ernestojimenez2107/PCB-con-comunicacion-Infrarroja/README.md

<h1 align="center">📡 PCB de 4 capas · Arduino Nano + Infrarrojos</h1><p align="center">
  Del esquema eléctrico a una placa preparada para su revisión y fabricación.
  <br>
  <strong>Proyecto académico · EITE · Universidad de Las Palmas de Gran Canaria</strong>
</p><p align="center">
  
  
  
  
</p>✨ ¿De qué trata el proyecto?
Diseño de una placa de circuito impreso (PCB) de cuatro capas con Arduino Nano, conectores de expansión y un sistema de transmisión y recepción por infrarrojos. El circuito integra un oscilador de aproximadamente 40 kHz basado en un temporizador SE555D, lógica digital para controlar las señales y una etapa emisora y receptora de infrarrojos.

🔁 Diagrama de bloques

```mermaid
flowchart LR
    A["Arduino Nano"] -->|TX y control| L["Lógica digital"]
    O["Oscilador SE555D · 40 kHz"] --> L
    L --> E["LED IR · TSAL4400"]
    R["Receptor IR · TSOP18440"] --> X["Lógica de recepción"]
    X -->|RX| A
```
 Componentes principales
Bloque	Componentes / función

🧠 Control	Arduino Nano y conectores de expansión

⏱️ Oscilador	SE555D, señal de ~40 kHz

📤 Emisor IR	LED TSAL4400 y transistor MMBT2222A

📥 Receptor IR	TSOP18440

🔀 Lógica digital	74LVC2G86 y 74LVC2G08

⚡ Alimentación	Redes de 5 V, 3,3 V y masa

 Diseño de la PCB

Capa	Uso principal

🔴 TOP	Pistas y conexiones de la cara superior

🟢 GND	Plano interno de masa

🟠 POWER	Distribución de alimentación

🔵 BOTTOM	Pistas y conexiones de la cara inferior

La PCB incluye conectores, taladros de fijación, serigrafía y planos de cobre.
✅ Comprobaciones realizadas
- DRC de KiCad: 0 errores y 0 avisos en la última comprobación indicada.
- Archivos de fabricación: Gerber de las cuatro capas, máscaras, serigrafías y contorno.
- Taladrado: archivos PTH y NPTH generados.
- Montaje: archivo CSV de posición de componentes generado.
- Documentación: esquemas y capas de la PCB exportados a PDF.
[!IMPORTANT]
Antes de fabricar la PCB, hay que revisar los Gerber en el visor del fabricante y confirmar la compatibilidad de las huellas, la colocación de los conectores y los modelos 3D.

📂 Organización del repositorio

Practica_Diseno_PCB/
├── Práctica_Diseño_PCB.kicad_pro    # Proyecto KiCad

├── Práctica_Diseño_PCB.kicad_sch    # Esquema principal

├── Práctica_Diseño_PCB.kicad_pcb    # Diseño de la placa

├── arduino.kicad_sch               # Arduino y expansión

├── oscilador.kicad_sch             # Oscilador de 40 kHz

├── IR_Tx_Rx.kicad_sch              # Transmisor y receptor IR

├── alimentaciones.kicad_sch       # Alimentaciones

├── Fabricacion_PCB/                # Gerber y taladrado

├── Archivos de Montaje_PCB/        # Posiciones de componentes

├── Documentacion_PDF/              # PDF del esquema y la placa

La estructura muestra los archivos principales; los nombres de las carpetas de documentación pueden variar según la entrega.

El archivo de posición de componentes se encuentra en la carpeta de montaje. La BOM y el presupuesto de 10 y 100 placas forman parte de la documentación del proyecto, cuando se incluyan en el repositorio.
🎓 Contexto académico
Proyecto desarrollado para una práctica de diseño de circuitos impresos de la Escuela de Ingeniería de Telecomunicación y Electrónica (EITE) de la Universidad de Las Palmas de Gran Canaria (ULPGC).
<p align="center"><strong>🛠️ Diseñado con KiCad </strong></p>
