ernestojimenez2107/PCB-con-comunicacion-Infrarroja/BOM_Practica_Diseño_PCB.xlsx

Reference | Qty | Value | Footprint | Datasheet | Fabricante | Modelo | Proveedor | DigiKey | Descripción
A1 | 1 | Arduino_Nano_v3.x | MisPlacas:Arduino_Nano | https://mm.digikey.com/Volume0/opasdata/d220001/medias/docus/8938/1050_A000005.pdf | Arduino | A000005 | DigiKey | 1050-1001-ND | Arduino Nano v3.x
C1,C3,C4,C5 | 4 | 100n | Capacitor_SMD:C_0805_2012Metric_Pad1.18x1.45mm_HandSolder | https://mm.digikey.com/Volume0/opasdata/d220001/medias/docus/658/CL21B104KACNFNC_Spec.pdf | Samsung Electro-Mechanics | CL21B104KACNFNC | DigiKey | 1276-2442-1-ND | 0.1 µF ±10% 25V Ceramic Capacitor X7R 0805 (2012 Metric)
C2 | 1 | 15n | Capacitor_SMD:C_0805_2012Metric_Pad1.18x1.45mm_HandSolder | https://yageogroup.com/content/datasheet/asset/file/UPY-GPHC_X7R_6_3V-TO-250V | YAGEO | CC0805JRX7R9BB153 | DigiKey | 311-4273-1-ND | Unpolarized capacitor
D1 | 1 | SM5817PL-TP | MisDiodos:CR_5817PL-TP_MCC | https://www.mccsemi.com/pdf/Products/SM5817PL-SM5819PL(SOD-123FL).pdf | MCC (Micro Commercial Components) | SM5817PL-TP | DigiKey | SM5817PL-TPMSCT-ND | Diodo 20 V 1A Montaje superficial SOD-123FL
D2 | 1 | TSAL4400 | LED_THT:LED_D3.0mm_IRBlack | http://www.vishay.com/docs/81006/tsal4400.pdf | Vishay Semiconductor Opto Division | TSAL4400 | DigiKey | 751-1201-ND | Infrared (IR) Emitter 940nm 1.35V 100mA 16mW/sr @ 100mA 50° Radial, 3mm Dia (T-1)
J1 | 1 | Conn_01x02 | MisTerminales:282837-2_TYC | https://www.te.com/commerce/DocumentDelivery/DDEController?Action=srchrtrv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 | TE Connectivity AMP Connectors | 282837-2 | DigiKey | A113320-ND | Generic connector, single row, 01x02, script generated (kicad-library-utils/schlib/autogen/connector/)
J2,J3 | 2 | Conn_01x12 | Connector_PinHeader_2.54mm:PinHeader_1x12_P2.54mm_Vertical | https://app.adam-tech.com/products/download/data_sheet/201605/ph1-xx-ua-data-sheet.pdf | Adam Tech | PH1-12-UA | DigiKey | 2057-PH1-12-UA-ND | Generic connector, single row, 01x12, script generated (kicad-library-utils/schlib/autogen/connector/)
Q1 | 1 | MMBT2222A | Package_TO_SOT_SMD:SOT-23 | https://www.mccsemi.com/pdf/Products/MMBT2222A(SOT-23).pdf | MCC (Micro Commercial Components) | MMBT2222A-TP | DigiKey | MMBT2222ATPMSCT-ND | Bipolar (BJT) Transistor NPN 40 V 600 mA 300MHz 350 mW Surface Mount SOT-23
R1 | 1 | 200 | Resistor_SMD:R_0805_2012Metric_Pad1.20x1.40mm_HandSolder | https://www.seielect.com/catalog/SEI-RMCF_RMCP.pdf | Stackpole Electronics Inc | RMCF0805JT200R | DigiKey | RMCF0805JT200RCT-ND | Resistor
R2 | 1 | 1.1k | Resistor_SMD:R_0805_2012Metric_Pad1.20x1.40mm_HandSolder | https://www.seielect.com/catalog/SEI-RMCF_RMCP.pdf | Stackpole Electronics Inc | RMCF0805JT1K10 | DigiKey | RMCF0805JT1K10CT-ND | 1.1 kOhms ±5% 0.125W, 1/8W Chip Resistor 0805 (2012 Metric) Automotive AEC-Q200 Thick Film
R3 | 1 | 4k7 | Resistor_SMD:R_0805_2012Metric_Pad1.20x1.40mm_HandSolder | https://www.seielect.com/catalog/SEI-RMCF_RMCP.pdf | Stackpole Electronics Inc | RMCF0805JT4K70 | DigiKey | RMCF0805JT4K70CT-ND | 4.7 kOhms ±5% 0.125W, 1/8W Resistencia en microprocesador 0805 (2012 métrico) AEC-Q200 automotriz Película gruesa
R4 | 1 | 100 | Resistor_SMD:R_0805_2012Metric_Pad1.20x1.40mm_HandSolder | https://www.seielect.com/catalog/SEI-RMCF_RMCP.pdf | Stackpole Electronics Inc | RMCF0805JT100R | DigiKey | RMCF0805JT100RCT-ND | 100 Ohms ±5% 0.125W, 1/8W Chip Resistor 0805 (2012 Metric) Automotive AEC-Q200 Thick Film
U1 | 1 | SE555D | Package_SO:SOIC-8_3.9x4.9mm_P1.27mm | http://www.ti.com/lit/ds/symlink/ne555.pdf | Texas Instruments | NE555DR | DigiKey | 296-6501-1-ND | Precision Timers, 555 compatible, SOIC-8
U2 | 1 | TSOP18440 | OptoDevice:Vishay_MOLD-3Pin | https://www.vishay.com/docs/82739/tsop184.pdf | Vishay Semiconductor Opto Division | TSOP18440 | DigiKey | TSOP18440-ND | Remote Receiver Sensor 40.0kHz 24m Through Hole
U3 | 1 | 74LVC2G86 | Package_SO:VSSOP-8_3x3mm_P0.65mm | https://www.ti.com/lit/ds/symlink/sn74lvc2g08.pdf?HQS=dis-dk-null-digikeymode-dsf-pf-null-wwe&ts=1790792621465 | Texas Instruments | SN74LVC2G86DCUR | DigiKey | 296-13275-1-ND | XOR (OR exclusivo) IC 2 Canal 8-VSSOP
U4 | 1 | 74LVC2G08 | Package_SO:VSSOP-8_3x3mm_P0.65mm | http://www.ti.com/lit/sg/scyt129e/scyt129e.pdf | Texas Instruments | SN74LVC2G08DCTR | DigiKey | 296-13263-1-ND | Dual AND Gate, Low-Voltage CMOS
