ernestojimenez2107/PCB-con-comunicacion-Infrarroja/Presupuesto_10 y 100 placas.xlsx

Sheet: 10 placas
Referencia | Valor | Fabricante | Modelo | DigiKey | Cantidad por placa | Cantidad total | Precio unitario | Precio total (€) | Moneda | País de compra | Enlace DigiKey
A1 | Arduino_Nano_v3.x | Arduino | A000005 | 1050-1001-ND | 1 | 10 | 22.361 | 223.61 | EUR | España | https://www.digikey.es/es/products/detail/arduino/A000005/2638989
C1,C3,C4,C5 | 100n | Samsung Electro-Mechanics | CL21B104KACNFNC | 1276-2442-1-ND | 4 | 40 | 0.026 | 1.04 | EUR | España | https://www.digikey.es/es/products/detail/samsung-electro-mechanics/CL21B104KACNFNC/3888100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
C2 | 15n | YAGEO | CC0805JRX7R9BB153 | 311-4273-1-ND | 1 | 10 | 0.088 | 0.88 | EUR | España | https://www.digikey.es/es/products/detail/yageo/CC0805JRX7R9BB153/5884116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
D1 | SM5817PL-TP | MCC (Micro Commercial Components) | SM5817PL-TP | SM5817PL-TPMSCT-ND | 1 | 10 | 0.138 | 1.38 | USD | Estados Unidos | https://www.digikey.com/es/products/detail/mcc-micro-commercial-components/SM5817PL-TP/1793251
D2 | TSAL4400 | Vishay Semiconductor Opto Division | TSAL4400 | 751-1201-ND | 1 | 10 | 0.289 | 2.89 | EUR | España | https://www.digikey.es/es/products/detail/vishay-semiconductor-opto-division/TSAL4400/1681336
J1 | Conn_01x02 | TE Connectivity AMP Connectors | 282837-2 | A113320-ND | 1 | 10 | 0.656 | 6.56 | EUR | España | https://www.digikey.es/es/products/detail/te-connectivity-amp-connectors/282837-2/2187973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
J2,J3 | Conn_01x12 | Adam Tech | PH1-12-UA | 2057-PH1-12-UA-ND | 2 | 20 | 0.133 | 2.66 | EUR | España | https://www.digikey.es/es/products/detail/adam-tech/PH1-12-UA/9830395
Q1 | MMBT2222A | MCC (Micro Commercial Components) | MMBT2222A-TP | MMBT2222ATPMSCT-ND | 1 | 10 | 0.078 | 0.78 | USD | Estados Unidos | https://www.digikey.com/es/products/detail/micro-commercial-co/MMBT2222A-TP/MMBT2222ATPMSCT-ND/717394
R1 | 200 | Stackpole Electronics Inc | RMCF0805JT200R | RMCF0805JT200RCT-ND | 1 | 10 | 0.02 | 0.2 | EUR | España | https://www.digikey.es/es/products/detail/stackpole-electronics-inc/RMCF0805JT200R/1757898
R2 | 1.1k | Stackpole Electronics Inc | RMCF0805JT1K10 | RMCF0805JT1K10CT-ND | 1 | 10 | 0.02 | 0.2 | EUR | España | https://www.digikey.es/es/products/detail/stackpole-electronics-inc/RMCF0805JT1K10/1757802
R3 | 4k7 | Stackpole Electronics Inc | RMCF0805JT4K70 | RMCF0805JT4K70CT-ND | 1 | 10 | 0.02 | 0.2 | EUR | España | https://www.digikey.es/es/products/detail/stackpole-electronics-inc/RMCF0805JT4K70/1757774
R4 | 100 | Stackpole Electronics Inc | RMCF0805JT100R | RMCF0805JT100RCT-ND | 1 | 10 | 0.02 | 0.2 | EUR | España | https://www.digikey.es/es/products/detail/stackpole-electronics-inc/RMCF0805JT100R/1757756
U1 | SE555D | Texas Instruments | NE555DR | 296-6501-1-ND | 1 | 10 | 0.205 | 2.05 | EUR | España | https://www.digikey.es/es/products/detail/texas-instruments/NE555DR/372491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
U2 | TSOP18440 | Vishay Semiconductor Opto Division | TSOP18440 | TSOP18440-ND | 1 | 10 | 0.636 | 6.36 | EUR | España | https://www.digikey.es/es/products/detail/vishay-semiconductor-opto-division/TSOP18440/8556535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
U3 | 74LVC2G86 | Texas Instruments | SN74LVC2G86DCUR | 296-13275-1-ND | 1 | 10 | 0.309 | 3.09 | EUR | España | https://www.digikey.es/es/products/detail/texas-instruments/SN74LVC2G86DCUR/484697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
U4 | 74LVC2G08 | Texas Instruments | SN74LVC2G08DCTR | 296-13263-1-ND | 1 | 10 | 0.32 | 3.2 | EUR | España | https://www.digikey.es/es/products/detail/texas-instruments/SN74LVC2G08DCTR/484829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

Sheet: 100 placas
Referencia | Valor | Fabricante | Modelo | DigiKey | Cantidad por placa | Cantidad total | Precio unitario | Precio total | Moneda | País de compra | Enlace DigiKey
A1 | Arduino_Nano_v3.x | Arduino | A000005 | 1050-1001-ND | 1 | 100 | 20.4172 | 2041.72 | EUR | España | https://www.digikey.es/es/products/detail/arduino/A000005/2638989
C1,C3,C4,C5 | 100n | Samsung Electro-Mechanics | CL21B104KACNFNC | 1276-2442-1-ND | 4 | 400 | 0.0146 | 5.84 | EUR | España | https://www.digikey.es/es/products/detail/samsung-electro-mechanics/CL21B104KACNFNC/3888100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
C2 | 15n | YAGEO | CC0805JRX7R9BB153 | 311-4273-1-ND | 1 | 100 | 0.0534 | 5.34 | EUR | España | https://www.digikey.es/es/products/detail/yageo/CC0805JRX7R9BB153/5884116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
D1 | SM5817PL-TP | MCC (Micro Commercial Components) | SM5817PL-TP | SM5817PL-TPMSCT-ND | 1 | 100 | 0.0849 | 8.49 | USD | Estados Unidos | https://www.digikey.com/es/products/detail/mcc-micro-commercial-components/SM5817PL-TP/1793251
D2 | TSAL4400 | Vishay Semiconductor Opto Division | TSAL4400 | 751-1201-ND | 1 | 100 | 0.2072 | 20.72 | EUR | España | https://www.digikey.es/es/products/detail/vishay-semiconductor-opto-division/TSAL4400/1681336
J1 | Conn_01x02 | TE Connectivity AMP Connectors | 282837-2 | A113320-ND | 1 | 100 | 0.466 | 46.6 | EUR | España | https://www.digikey.es/es/products/detail/te-connectivity-amp-connectors/282837-2/2187973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
J2,J3 | Conn_01x12 | Adam Tech | PH1-12-UA | 2057-PH1-12-UA-ND | 2 | 200 | 0.1134 | 22.68 | EUR | España | https://www.digikey.es/es/products/detail/adam-tech/PH1-12-UA/9830395
Q1 | MMBT2222A | MCC (Micro Commercial Components) | MMBT2222A-TP | MMBT2222ATPMSCT-ND | 1 | 100 | 0.048 | 4.8 | USD | Estados Unidos | https://www.digikey.com/es/products/detail/micro-commercial-co/MMBT2222A-TP/MMBT2222ATPMSCT-ND/717394
R1 | 200 | Stackpole Electronics Inc | RMCF0805JT200R | RMCF0805JT200RCT-ND | 1 | 100 | 0.0095 | 0.95 | EUR | España | https://www.digikey.es/es/products/detail/stackpole-electronics-inc/RMCF0805JT200R/1757898
R2 | 1.1k | Stackpole Electronics Inc | RMCF0805JT1K10 | RMCF0805JT1K10CT-ND | 1 | 100 | 0.0095 | 0.95 | EUR | España | https://www.digikey.es/es/products/detail/stackpole-electronics-inc/RMCF0805JT1K10/1757802
R3 | 4k7 | Stackpole Electronics Inc | RMCF0805JT4K70 | RMCF0805JT4K70CT-ND | 1 | 100 | 0.0095 | 0.95 | EUR | España | https://www.digikey.es/es/products/detail/stackpole-electronics-inc/RMCF0805JT4K70/1757774
R4 | 100 | Stackpole Electronics Inc | RMCF0805JT100R | RMCF0805JT100RCT-ND | 1 | 100 | 0.0095 | 0.95 | EUR | España | https://www.digikey.es/es/products/detail/stackpole-electronics-inc/RMCF0805JT100R/1757756
U1 | SE555D | Texas Instruments | NE555DR | 296-6501-1-ND | 1 | 100 | 0.1569 | 15.69 | EUR | España | https://www.digikey.es/es/products/detail/texas-instruments/NE555DR/372491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
U2 | TSOP18440 | Vishay Semiconductor Opto Division | TSOP18440 | TSOP18440-ND | 1 | 100 | 0.5413 | 54.13 | EUR | España | https://www.digikey.es/es/products/detail/vishay-semiconductor-opto-division/TSOP18440/8556535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
U3 | 74LVC2G86 | Texas Instruments | SN74LVC2G86DCUR | 296-13275-1-ND | 1 | 100 | 0.2397 | 23.97 | EUR | España | https://www.digikey.es/es/products/detail/texas-instruments/SN74LVC2G86DCUR/484697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
U4 | 74LVC2G08 | Texas Instruments | SN74LVC2G08DCTR | 296-13263-1-ND | 1 | 100 | 0.2486 | 24.86 | EUR | España | https://www.digikey.es/es/products/detail/texas-instruments/SN74LVC2G08DCTR/484829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

Sheet: Resumen
DigiKey España |  |  | RESUMEN FINAL | 10 placas (IVA) | 10 placas (IGIC) | 100 placas (IVA) | 100 placas (IGIC)
Concepto | 10 placas | 100 placas | Total DigiKey España | 306.2994 | 270.8598 | 2741.0735 | 2423.9245
Componentes España (€) | 253.14 | 2265.35 | Total DigiKey EEUU | 40.17169024 | 35.52372608 | 52.20337606 | 46.16331602
Transporte (€) | GRATIS | GRATIS | Total Presupuesto | 346.4710902 | 306.3835261 | 2793.276876 | 2470.087816
Total componentes (€) | 253.14 | 2265.35
Aduanas y gestión (€) | 0 * | 0 *
IVA aplicable (€) | 53.1594 | 475.7235
IGIC (€) | 17.7198 | 158.5745
TOTAL FINAL (con IVA) | 306.2994 | 2741.0735
TOTAL FINAL (con IGIC) | 270.8598 | 2423.9245
*Se supone que los gastos aduaneros los asume DigiKey mediante DDP. Los importes son provisionales y no incluyen cargos adicionales que pudieran aplicarse.
DigiKey EEUU
Concepto | 10 placas | 100 placas
Componentes EEUU (USD) | 2.16 | 13.29
Conversión USD a EUR | 1.929744 | 11.873286
Transporte (€) | 31.27 | 31.27
Aduanas y gestión (€) | 0 * | 0 *
IVA aplicable (€) | 6.97194624 | 9.06009006
IGIC (€) | 2.32398208 | 3.02003002
TOTAL FINAL con IVA(€) | 40.17169024 | 52.20337606
TOTAL FINAL con IGIC(€) | 35.52372608 | 46.16331602
*Se supone que los gastos aduaneros los asume DigiKey mediante DDP. Los importes son provisionales y no incluyen cargos adicionales que pudieran aplicarse.
