ernestojimenez2107/PCB-con-comunicacion-Infrarroja/Placa_pdf.pdf

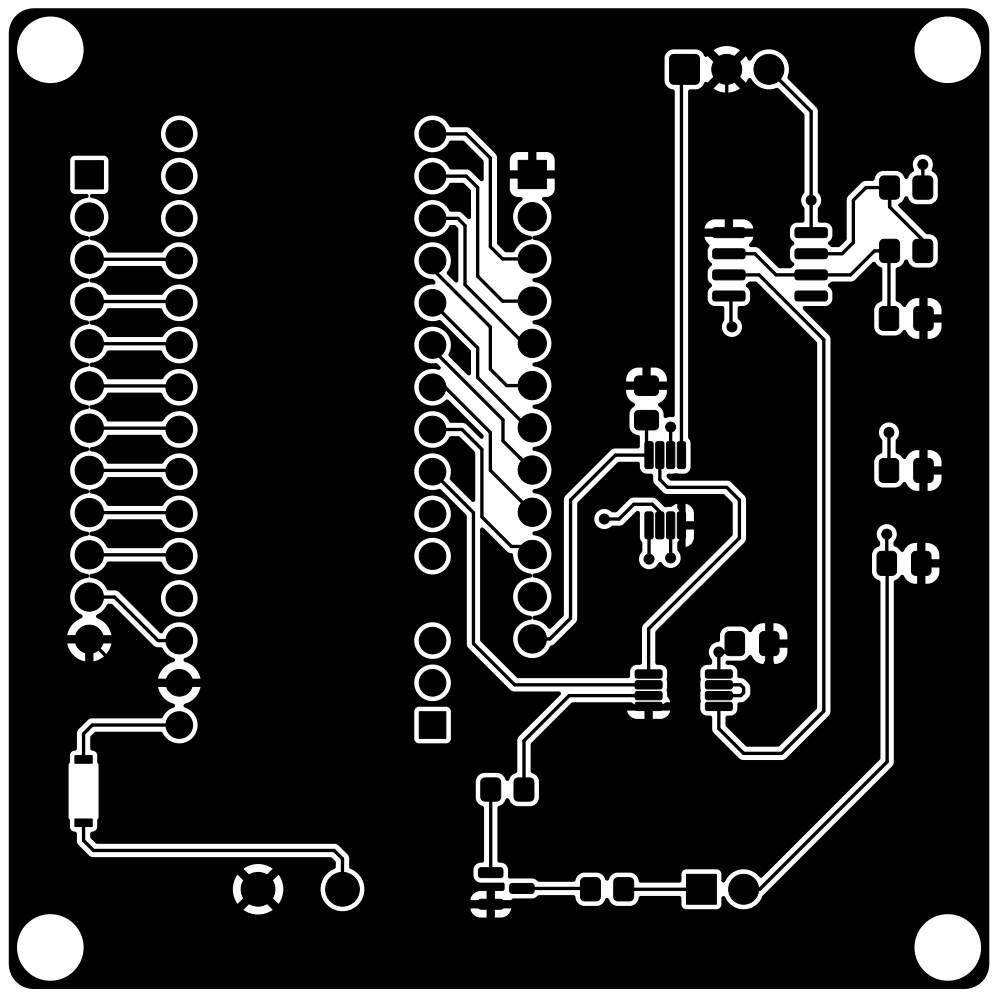
[picture p1: page 1]

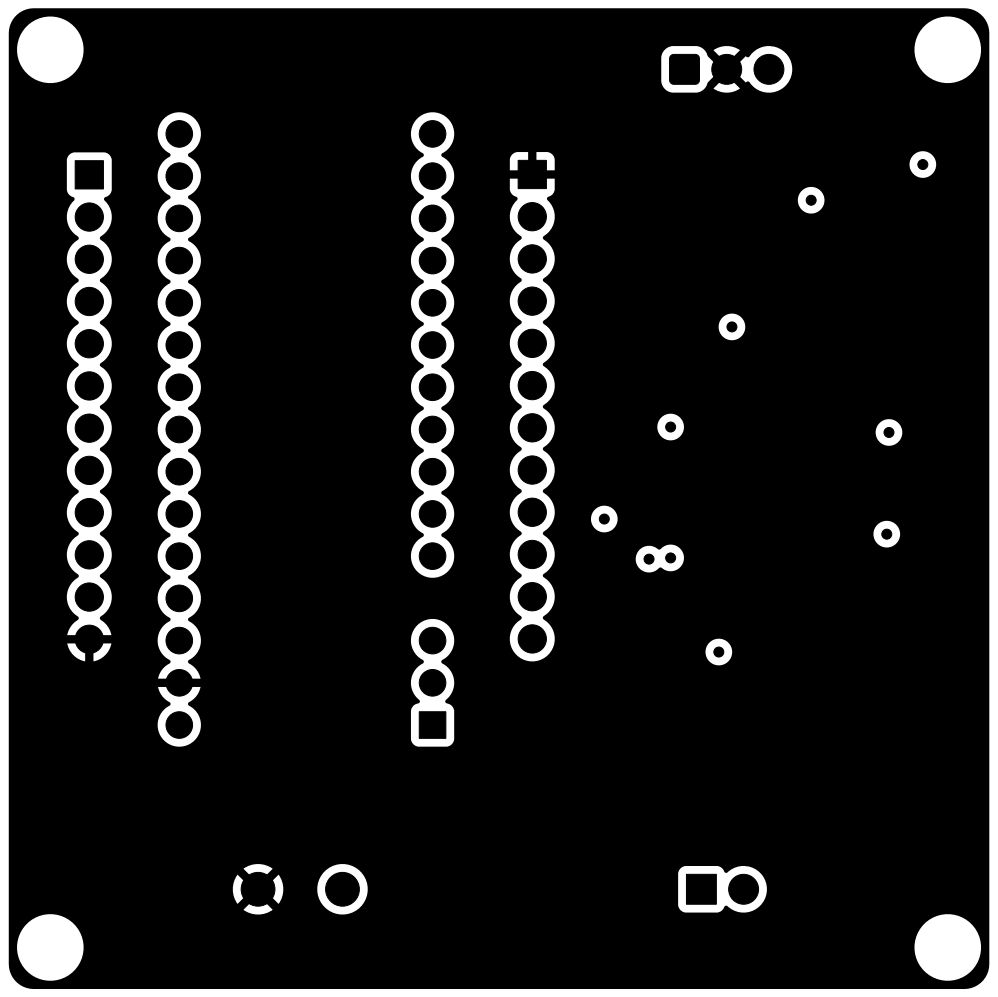
[picture p2: page 2]

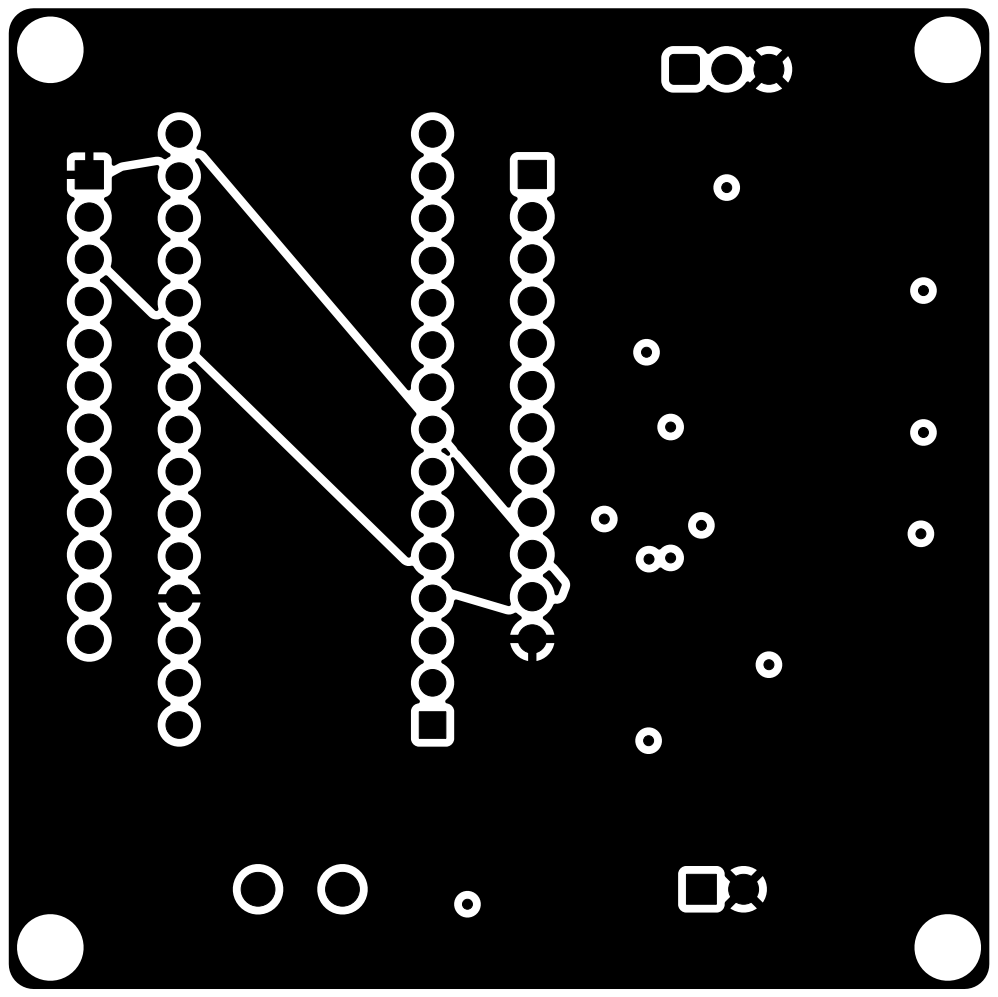
[picture p3: page 3]

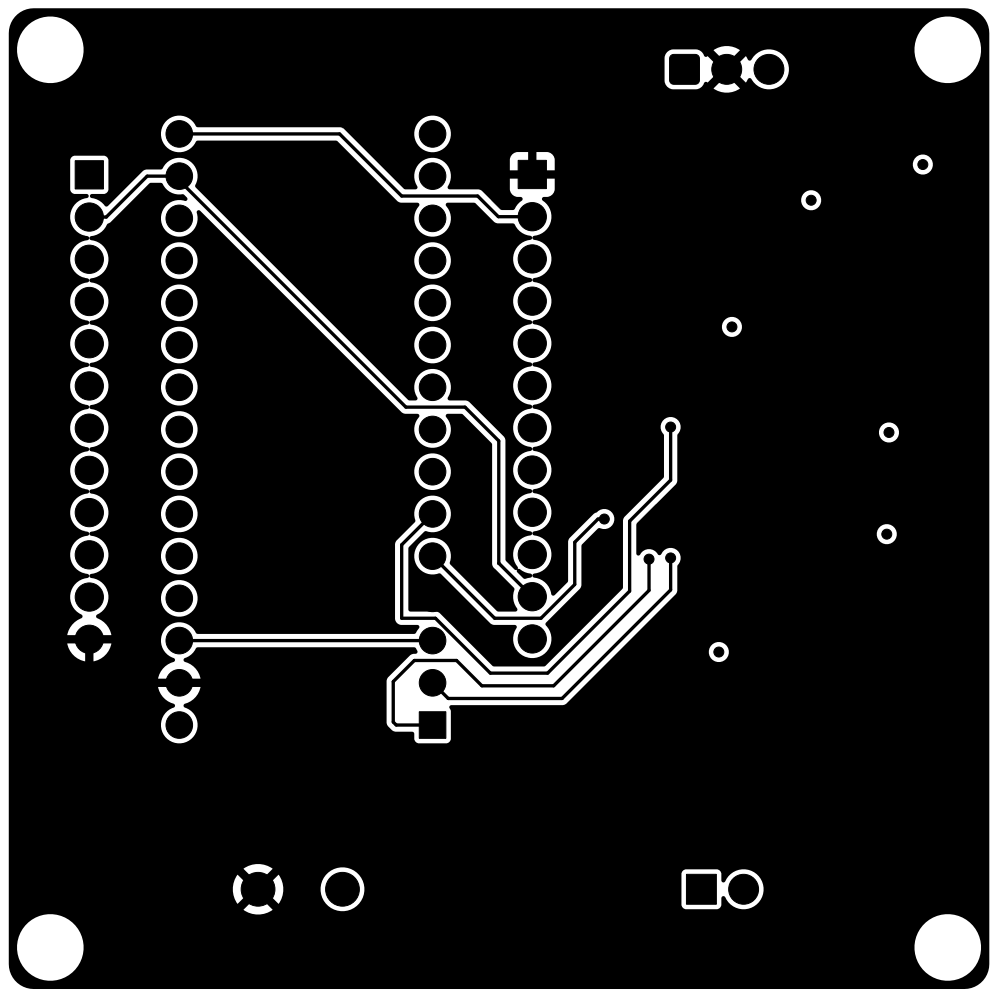
[picture p4: page 4]

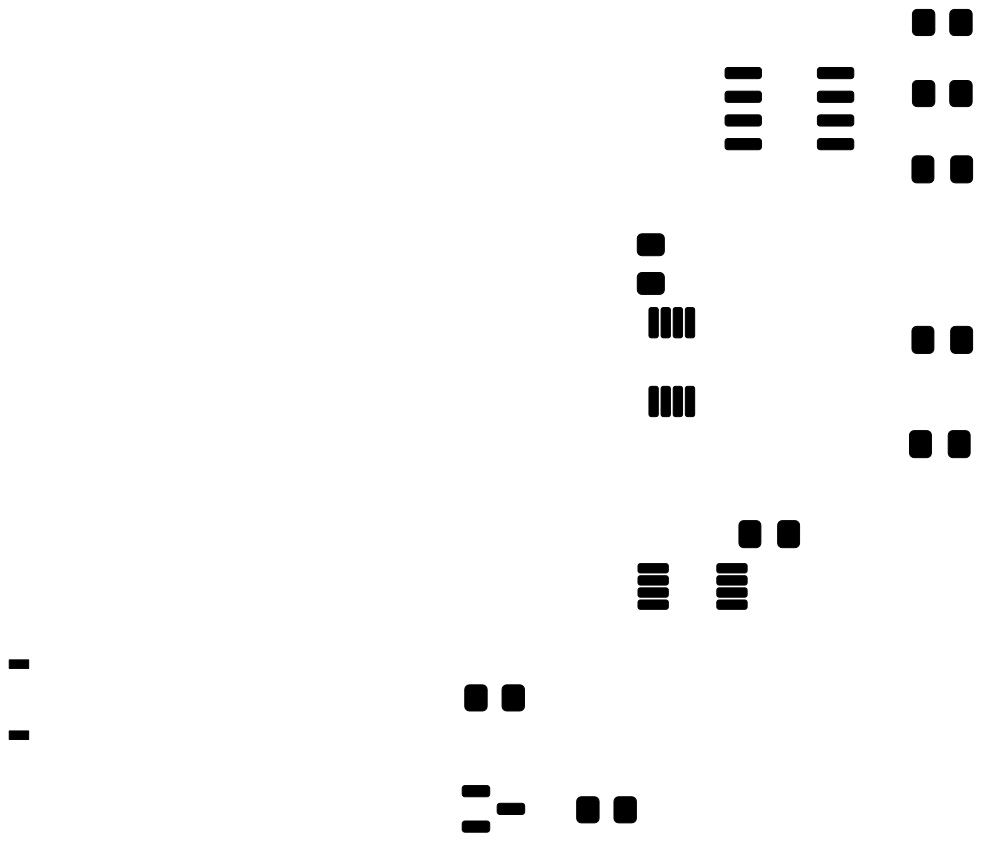
[picture p5: page 5]

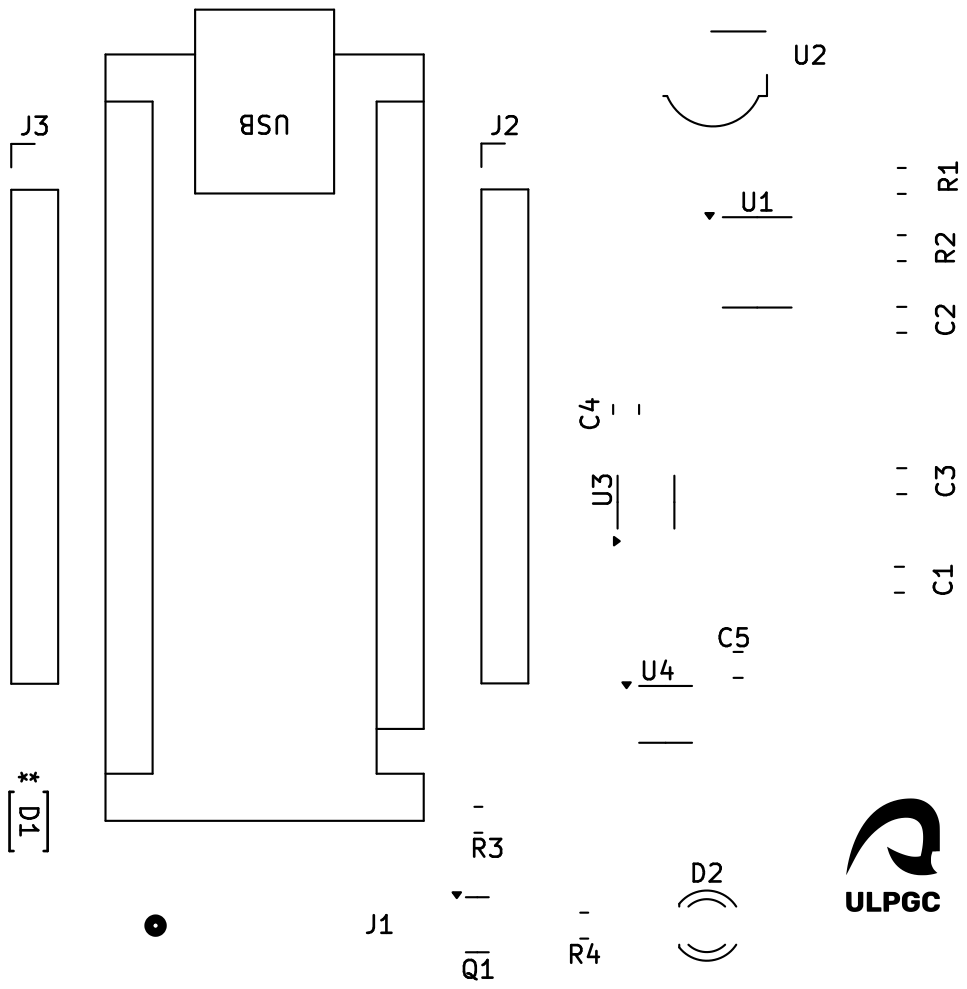
[picture p6: page 7]

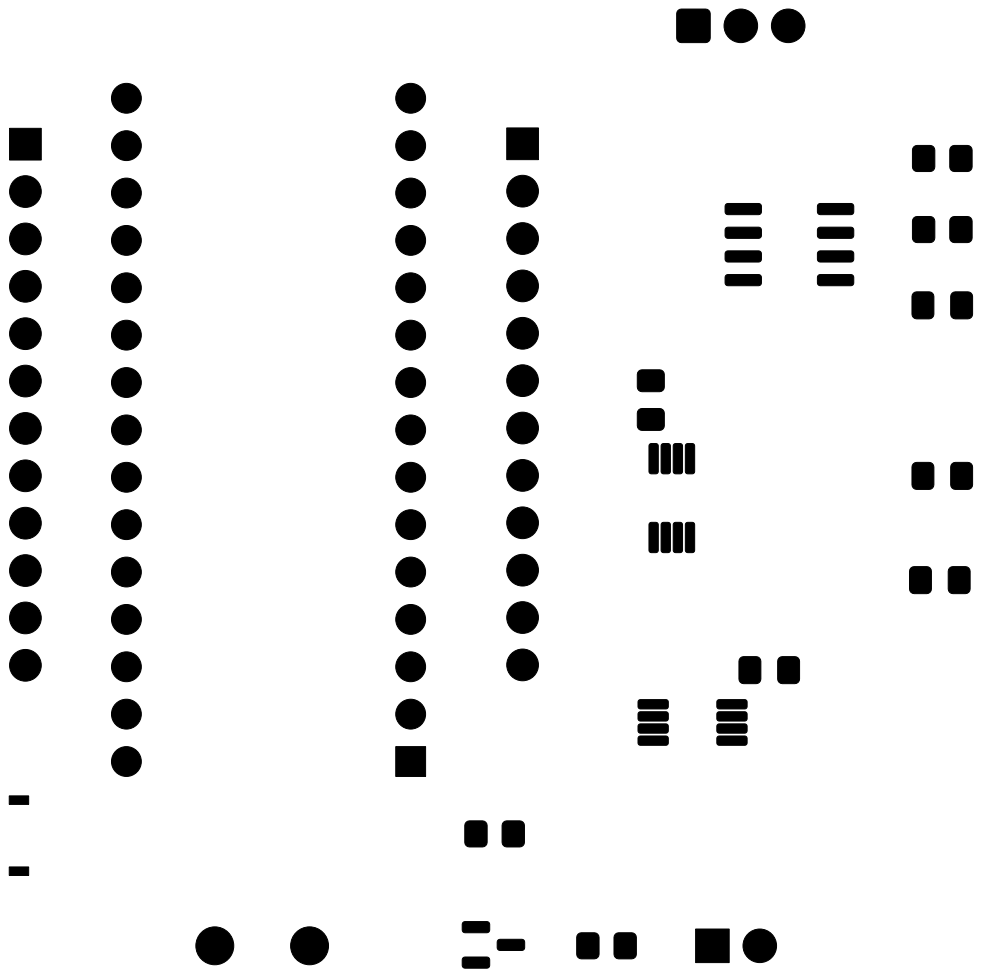
[picture p7: page 9]

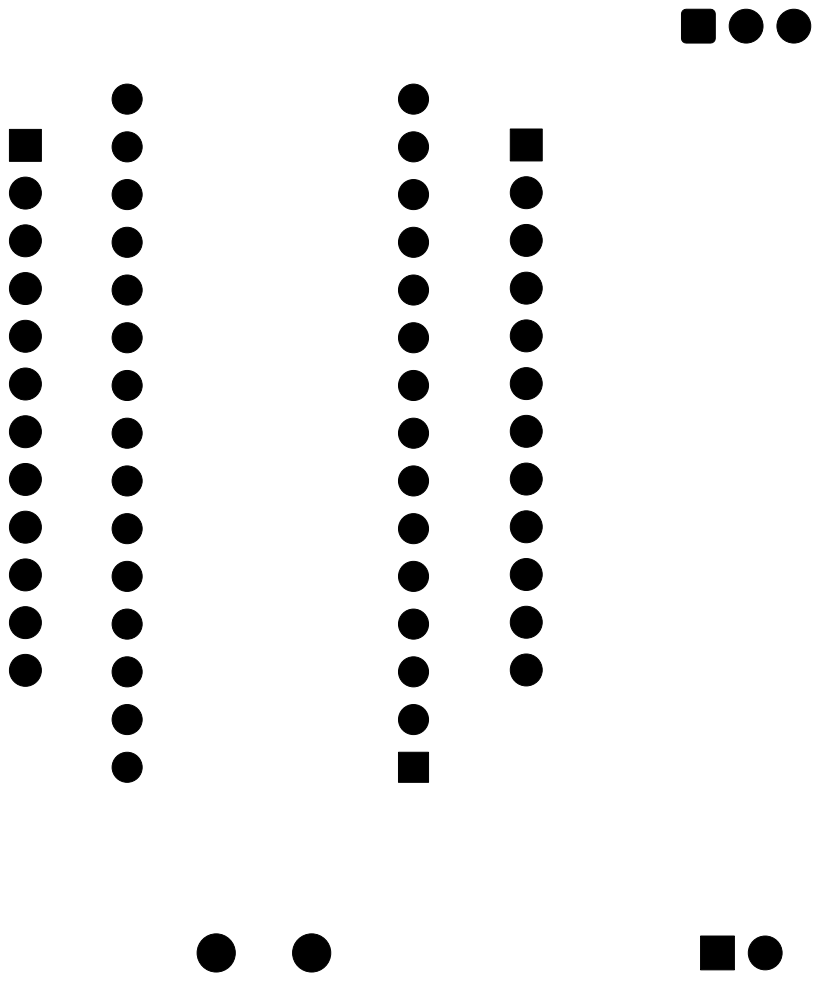
[picture p8: page 10]

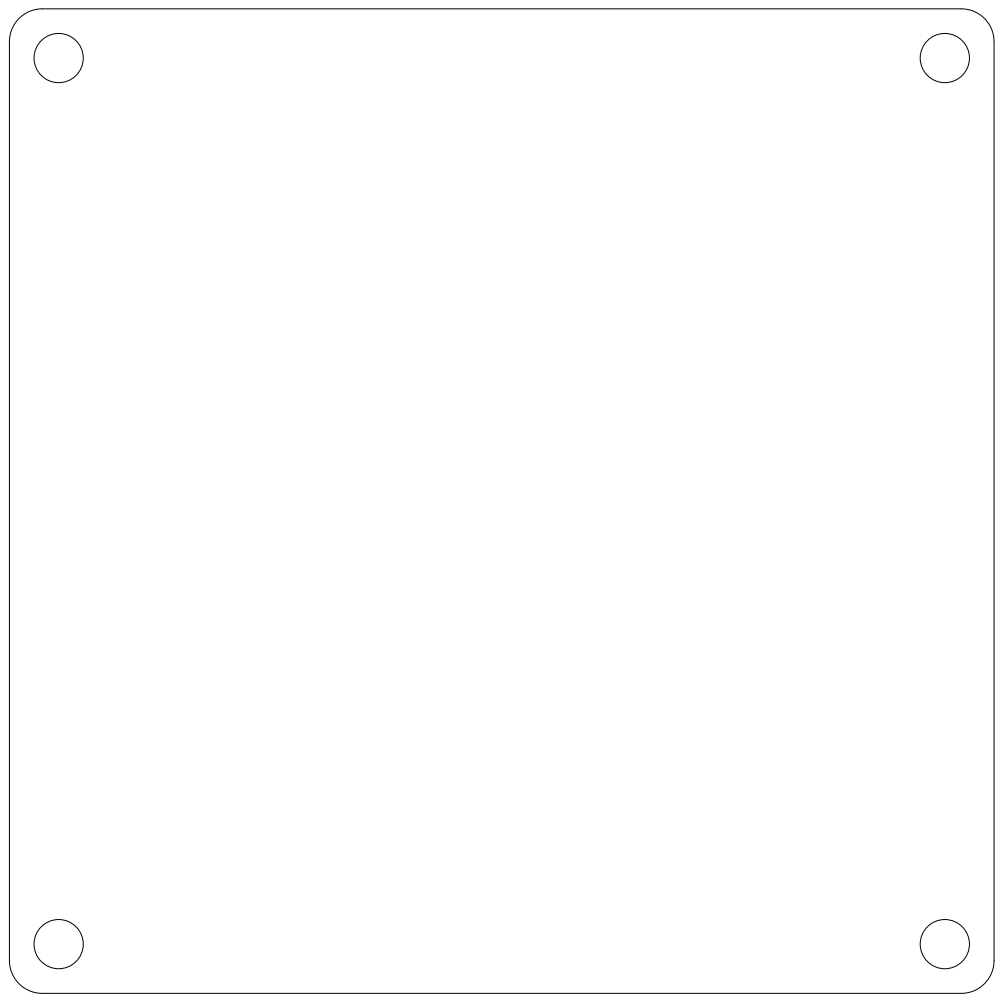
[picture p9: page 11]
