ernestojimenez2107/PCB-con-comunicacion-Infrarroja/Práctica_Diseño_PCB.kicad_pcb

## KiCad design Práctica_Diseño_PCB.kicad_pcb (2026-11-09)

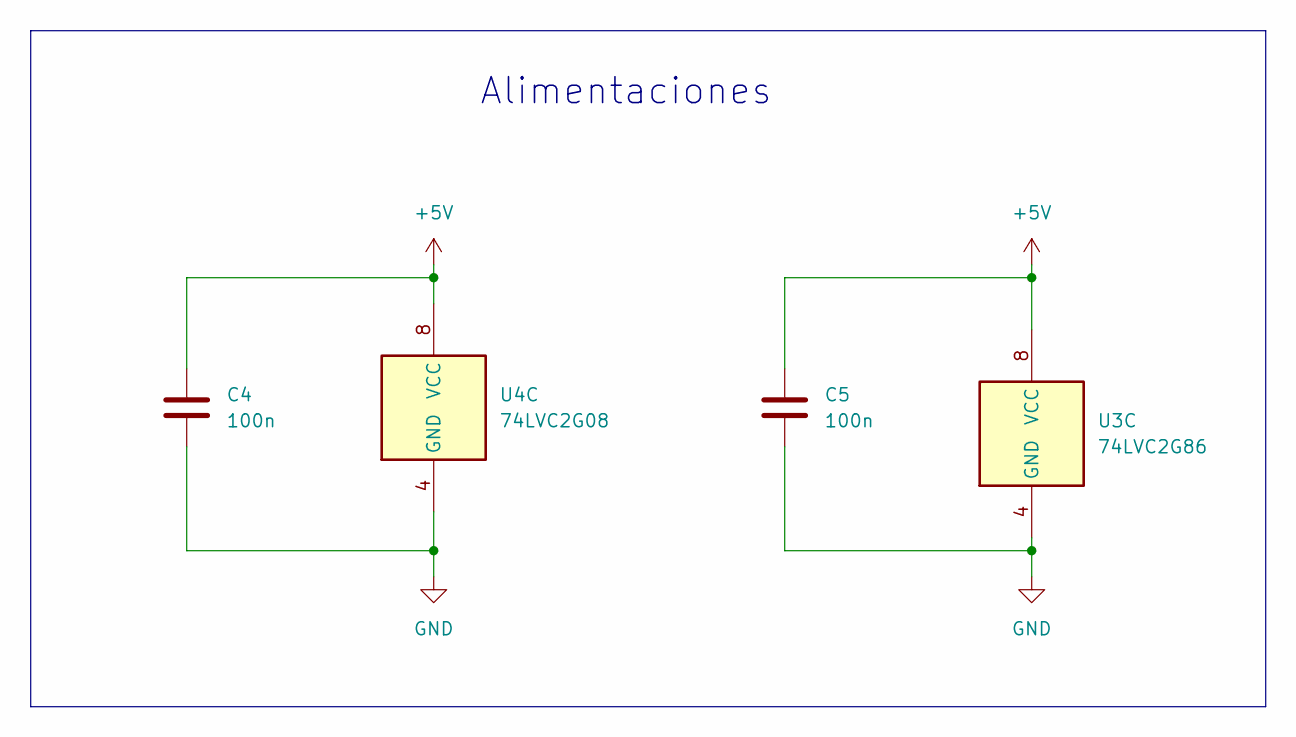
[picture p10: schematic alimentaciones.kicad_sch]

Parts:
C4, C5: 100n; C_0805_2012Metric_Pad1.18x1.45mm_HandSolder; DigiKey 1276-2442-1-ND
U3: 74LVC2G86; VSSOP-8_3x3mm_P0.65mm; DigiKey 296-13275-1-ND
U4: 74LVC2G08; VSSOP-8_3x3mm_P0.65mm; DigiKey 296-13263-1-ND

Connections:
+5V: C4.1, C5.1, U3.8 (VCC), U4.8 (VCC); also elsewhere on the board
GND: C4.2, C5.2, U3.4 (GND), U4.4 (GND); also elsewhere on the board

Notes on the sheet:
Alimentaciones

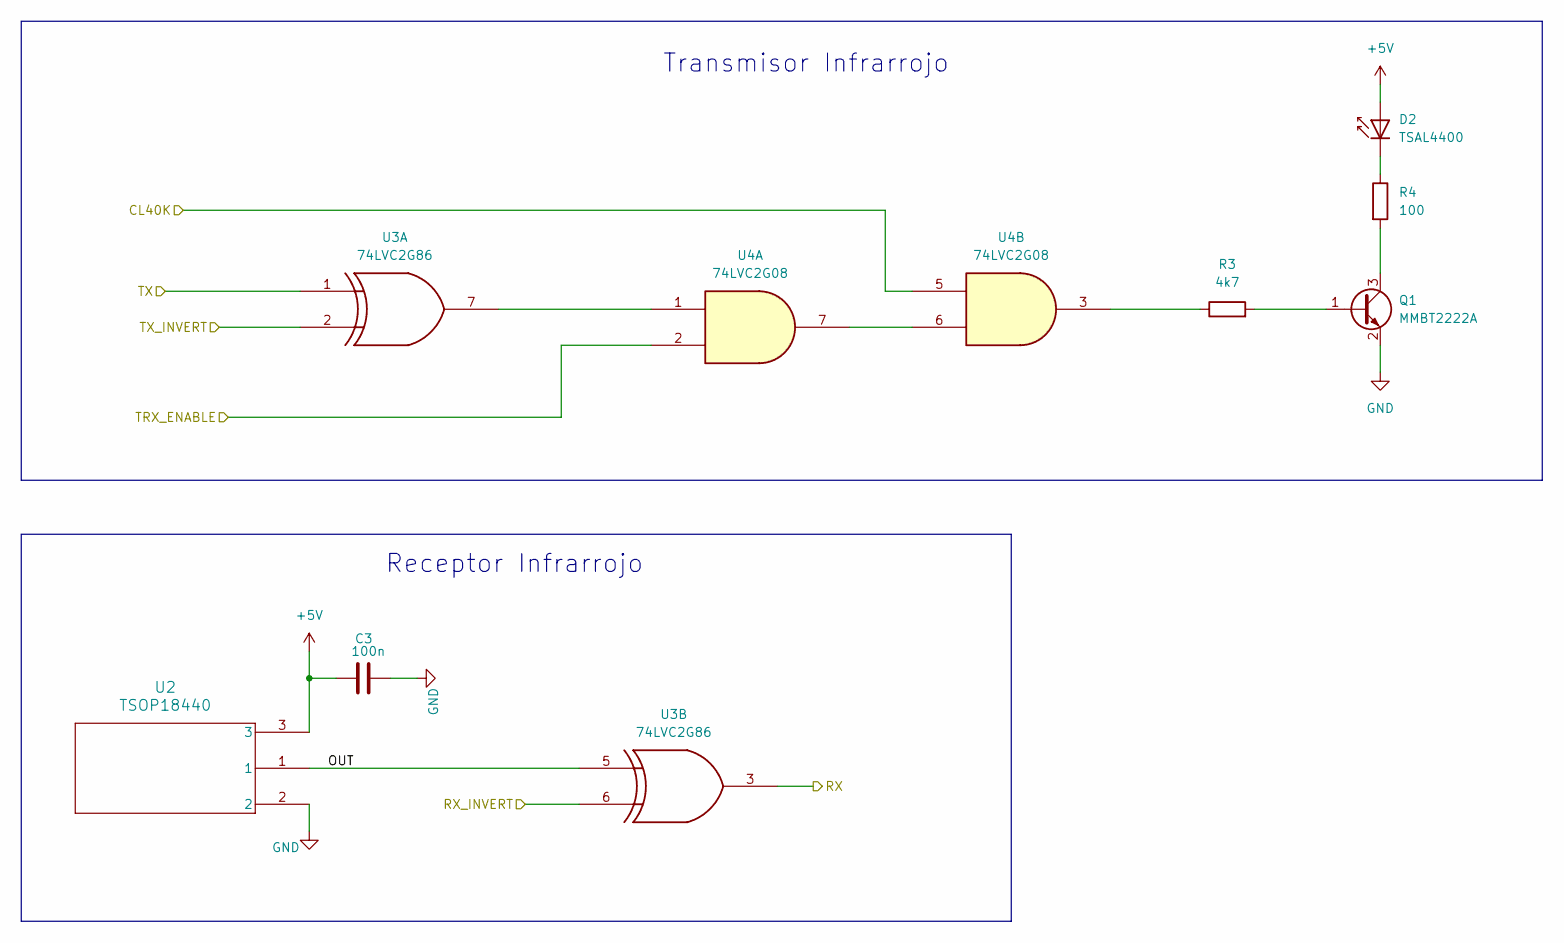
[picture p11: schematic IR_Tx_Rx.kicad_sch, Transmisor Infrarrojo]

Parts:
C3: 100n; C_0805_2012Metric_Pad1.18x1.45mm_HandSolder; DigiKey 1276-2442-1-ND
D2: TSAL4400; LED_D3.0mm_IRBlack; DigiKey 751-1201-ND
Q1: MMBT2222A; SOT-23; DigiKey MMBT2222ATPMSCT-ND
R3: 4k7; R_0805_2012Metric_Pad1.20x1.40mm_HandSolder; DigiKey RMCF0805JT4K70CT-ND
R4: 100; R_0805_2012Metric_Pad1.20x1.40mm_HandSolder; DigiKey RMCF0805JT100RCT-ND
U2: TSOP18440; Vishay_MOLD-3Pin; DigiKey TSOP18440-ND
U3: 74LVC2G86; VSSOP-8_3x3mm_P0.65mm; DigiKey 296-13275-1-ND
U4: 74LVC2G08; VSSOP-8_3x3mm_P0.65mm; DigiKey 296-13263-1-ND

Connections:
+5V: C3.2, D2.2 (A), U2.3; also elsewhere on the board
/Arduino Nano/RX: U3.3; also elsewhere on the board
/Arduino Nano/RX_INVERT: U3.6; also elsewhere on the board
/Arduino Nano/TRX_ENABLE: U4.2; also elsewhere on the board
/Arduino Nano/TX: U3.1; also elsewhere on the board
/Arduino Nano/TX_INVERT: U3.2; also elsewhere on the board
/Oscilador/CL40K: U4.5; also elsewhere on the board
/Tx_Rx_Infrarrojo/OUT: U2.1, U3.5
GND: C3.1, Q1.2 (E), U2.2; also elsewhere on the board
unnamed: D2.1 (K), R4.1
unnamed: Q1.1 (B), R3.2
unnamed: Q1.3 (C), R4.2
unnamed: R3.1, U4.3
unnamed: U3.7, U4.1
unnamed: U4.6, U4.7

Notes on the sheet:
Transmisor Infrarrojo
Receptor Infrarrojo

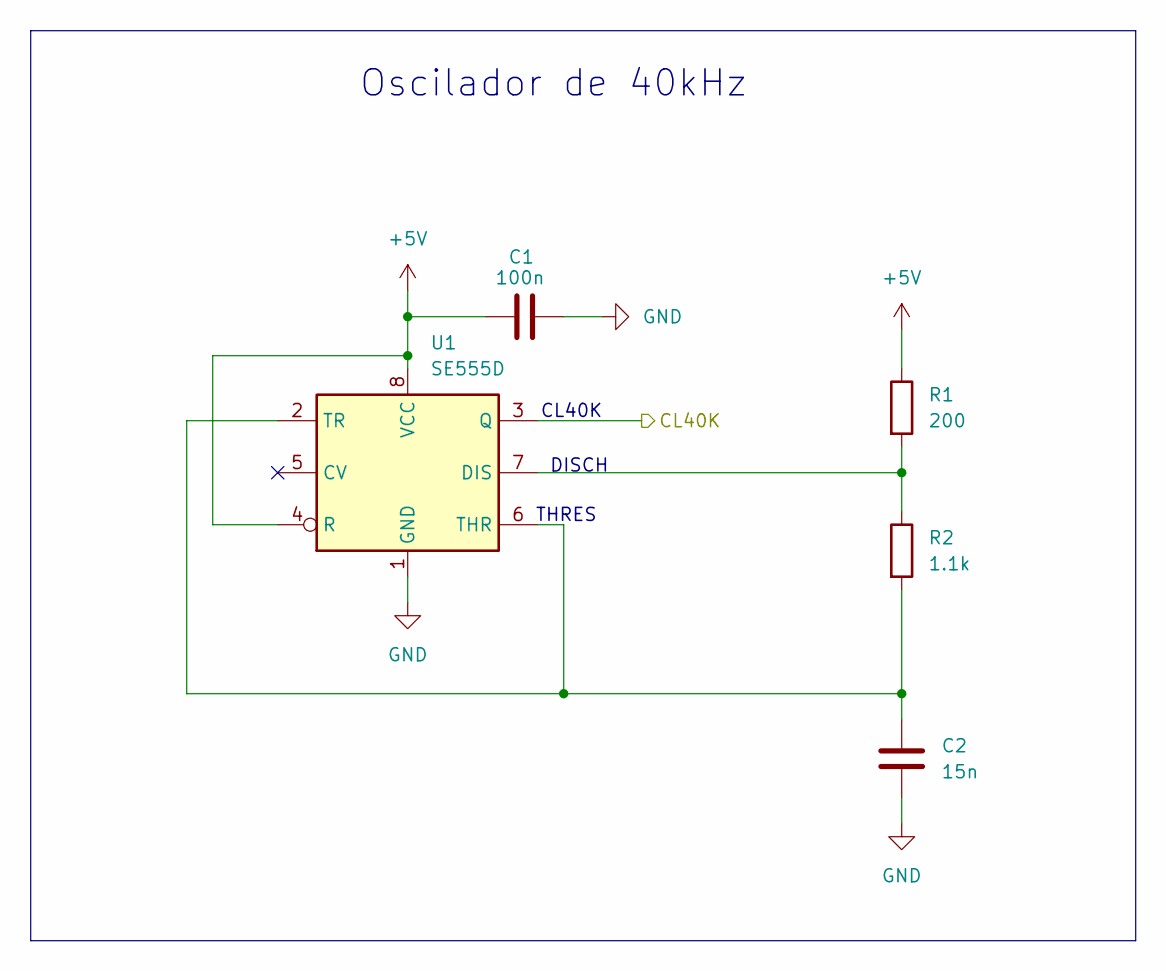
[picture p12: schematic oscilador.kicad_sch, Multivibrador a 40kHz]

Parts:
C1: 100n; C_0805_2012Metric_Pad1.18x1.45mm_HandSolder; DigiKey 1276-2442-1-ND
C2: 15n; C_0805_2012Metric_Pad1.18x1.45mm_HandSolder; DigiKey 311-4273-1-ND
R1: 200; R_0805_2012Metric_Pad1.20x1.40mm_HandSolder; DigiKey RMCF0805JT200RCT-ND
R2: 1.1k; R_0805_2012Metric_Pad1.20x1.40mm_HandSolder; DigiKey RMCF0805JT1K10CT-ND
U1: SE555D; SOIC-8_3.9x4.9mm_P1.27mm; DigiKey 296-6501-1-ND

Connections:
+5V: C1.1, R1.1, U1.4 (R), U1.8 (VCC); also elsewhere on the board
/Oscilador/CL40K: U1.3 (Q); also elsewhere on the board
GND: C1.2, C2.2, U1.1 (GND); also elsewhere on the board
unnamed: R1.2, R2.1, U1.7 (DIS)
unnamed: C2.1, R2.2, U1.2 (TR), U1.6 (THR)

Notes on the sheet:
THRES
DISCH
CL40K
Oscilador de 40kHz

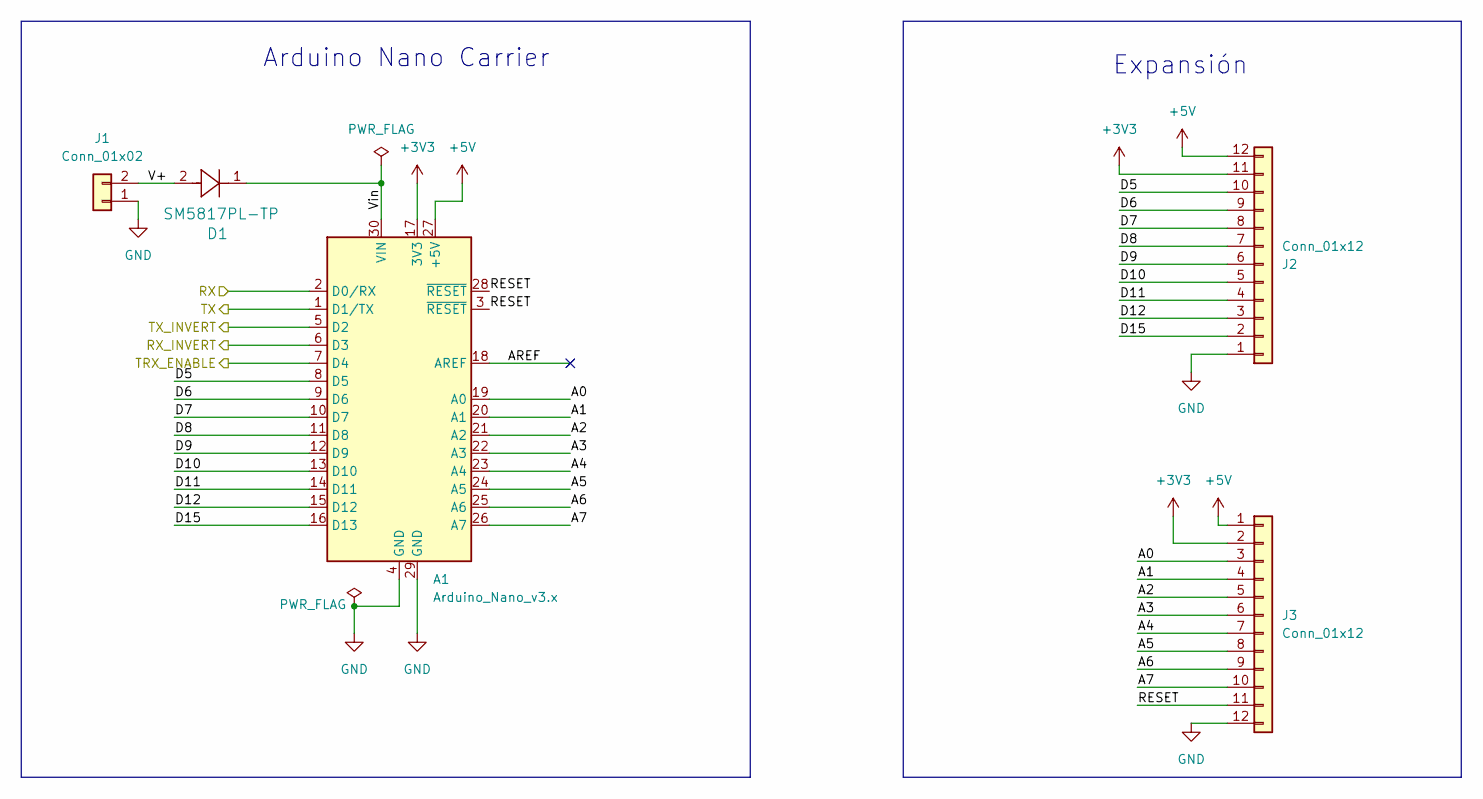
[picture p13: schematic arduino.kicad_sch, Arduino Nano y Expansión]

Parts:
A1: Arduino_Nano_v3.x; Arduino_Nano; DigiKey 1050-1001-ND
D1: SM5817PL-TP; CR_5817PL-TP_MCC; DigiKey SM5817PL-TPMSCT-ND
J1: Conn_01x02; 282837-2_TYC; DigiKey A113320-ND
J2, J3: Conn_01x12; PinHeader_1x12_P2.54mm_Vertical; DigiKey 2057-PH1-12-UA-ND

Connections:
+3V3: A1.17 (3V3), J2.11, J3.2
+5V: A1.27 (+5V), J2.12, J3.1; also elsewhere on the board
/Arduino Nano/A0: A1.19 (A0), J3.3
/Arduino Nano/A1: A1.20 (A1), J3.4
/Arduino Nano/A2: A1.21 (A2), J3.5
/Arduino Nano/A3: A1.22 (A3), J3.6
/Arduino Nano/A4: A1.23 (A4), J3.7
/Arduino Nano/A5: A1.24 (A5), J3.8
/Arduino Nano/A6: A1.25 (A6), J3.9
/Arduino Nano/A7: A1.26 (A7), J3.10
/Arduino Nano/AREF: A1.18 (AREF)
/Arduino Nano/D5: A1.8 (D5), J2.10
/Arduino Nano/D6: A1.9 (D6), J2.9
/Arduino Nano/D7: A1.10 (D7), J2.8
/Arduino Nano/D8: A1.11 (D8), J2.7
/Arduino Nano/D9: A1.12 (D9), J2.6
/Arduino Nano/D10: A1.13 (D10), J2.5
/Arduino Nano/D11: A1.14 (D11), J2.4
/Arduino Nano/D12: A1.15 (D12), J2.3
/Arduino Nano/D15: A1.16 (D13), J2.2
/Arduino Nano/RESET: A1.3 (~RESET), A1.28 (~RESET), J3.11
/Arduino Nano/RX: A1.2 (D0/RX); also elsewhere on the board
/Arduino Nano/RX_INVERT: A1.6 (D3); also elsewhere on the board
/Arduino Nano/TRX_ENABLE: A1.7 (D4); also elsewhere on the board
/Arduino Nano/TX: A1.1 (D1/TX); also elsewhere on the board
/Arduino Nano/TX_INVERT: A1.5 (D2); also elsewhere on the board
/Arduino Nano/V+: D1.2, J1.2
/Arduino Nano/Vin: A1.30 (VIN), D1.1
GND: A1.4 (GND), A1.29 (GND), J1.1, J2.1, J3.12; also elsewhere on the board

Notes on the sheet:
Arduino Nano Carrier
Expansión

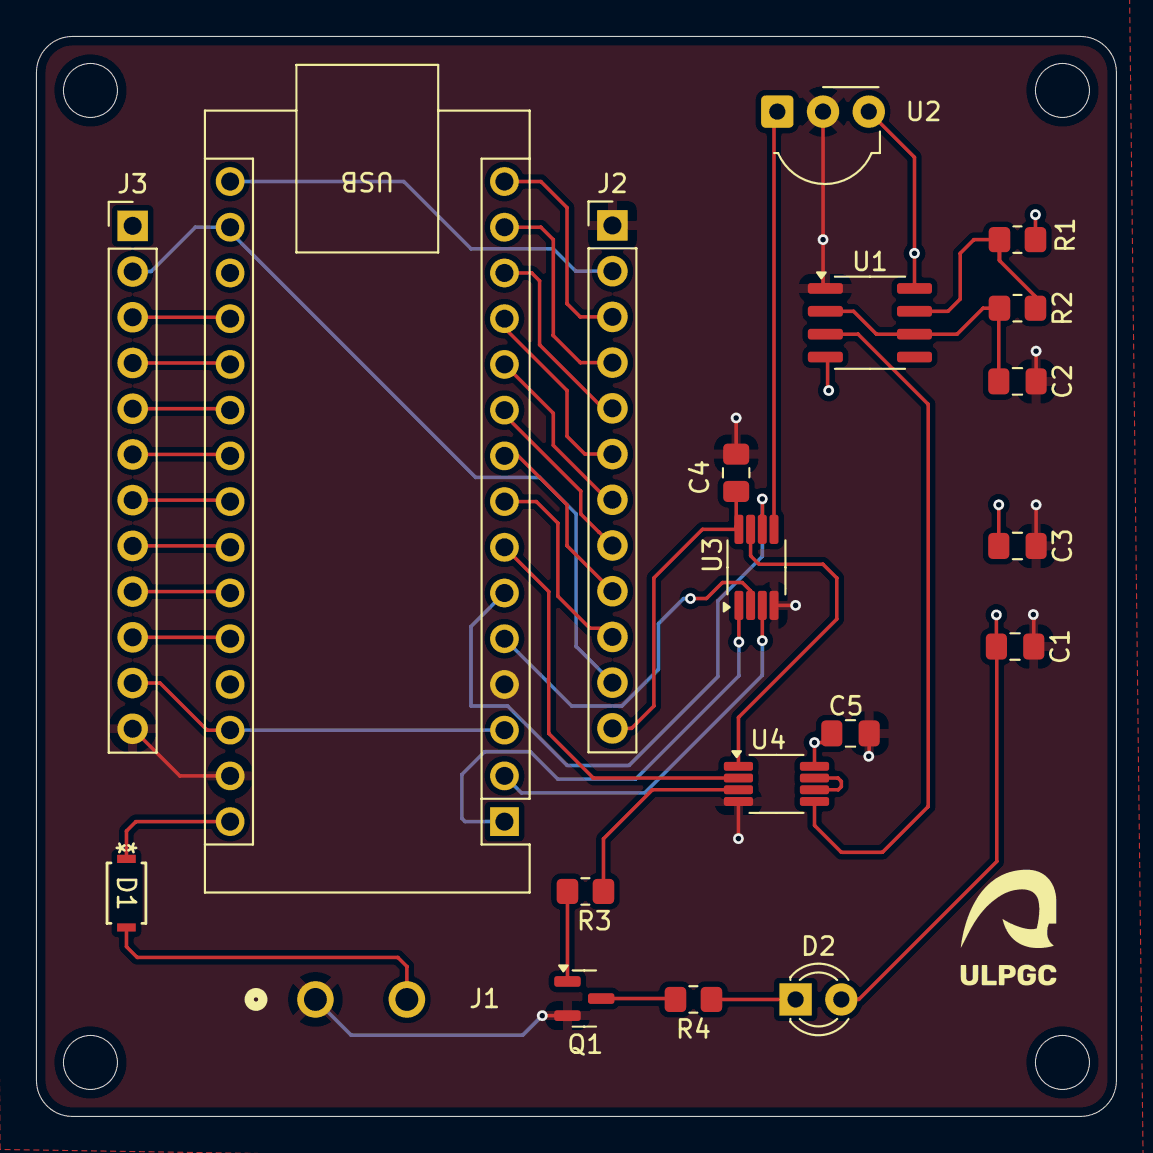
[picture p14: board Práctica_Diseño_PCB.kicad_pcb from above]

Board: 4 copper layers, 60.0 x 60.0 mm, 20 parts (1 on the bottom side), 38 nets.
