ernestojimenez2107/PCB-con-comunicacion-Infrarroja/(commit log)

2026-11-09 Enhance project description in README.md
    Added detailed description of the PCB design and its components.
2026-11-09 Update project description in README
    Removed communication and Arduino references from the README.
